AirQualityGermany/AirQuality-project-2018_2019-F.I.R-and-Geotab-GmbH/Pinouts and wiring overviews/WEMOS LOLIN32 V1.0.0 Wifi + Bluetooth Board Based ESP-32.JPG

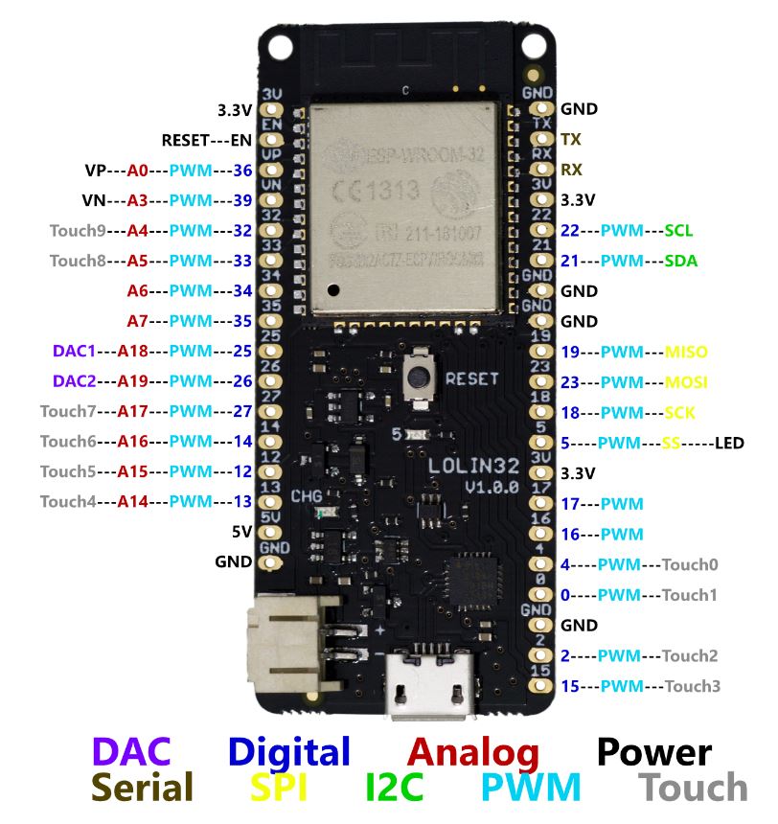
Pinouts and wiring overviews/WEMOS LOLIN32 V1.0.0 Wifi + Bluetooth Board Based ESP-32.JPG
