AirQualityGermany/AirQuality-project-2018_2019-F.I.R-and-Geotab-GmbH/Pinouts and wiring overviews/BME280-Wiring-Guide-Schematics-Guide-14core.jpg

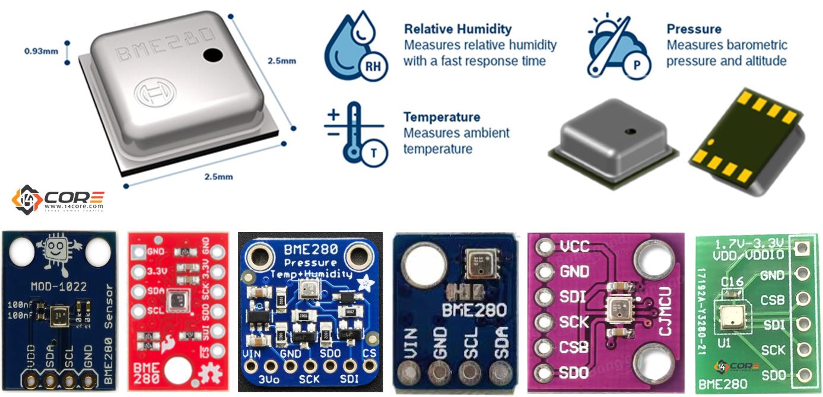
Pinouts and wiring overviews/BME280-Wiring-Guide-Schematics-Guide-14core.jpg
