AirQualityGermany/AirQuality-project-2018_2019-F.I.R-and-Geotab-GmbH/BluetoothBroadcasting/Broadcastdesign_v1_0.pdf

# Broadcast Design (v1.0)

Offset | 1 | 2 | 3 | 4 | 5 | 6 | 7 | 8 | 9 | 10 | 11 | 12 | 13 | 14 | 15 | 16 | 17 | 18 | 19 | 20 | 21 | 22 | 23 | 24 | 25 | 26
Value | 0x02 | 0x01 | 0x06 | 0x16 | 0xFF | 0x0275 | | 0x00 | 0xC6 | 0x64 | 0x07 | Data | Data | Data | 0x09 | Data | Data | Data | 0x0A | Data | Data | Data | 0XE6 | Data | 0xE7 | Data
Description | AD length (length = 2) | Flags | -LE Discov erable Moder – BR/DE R Not Suppor ted | AD length (length = 22) | Manuf acturer specifi c Data | Geotab‘s Company ID | | Adverti sing packet version numbe r | Tx Power Level (-58dBm ) | Batter y Power Level (100%) | Tempe rature | Temperature Data - Floating Point 24 Bit | | | Relativ e Humidi ty | Humidity Data - Floating Point 24 Bit | | | Barom etric Pressu re | Pressure Data - Floating Point 24 Bit | | | Generi c Byte 1 è PM2.5 | PM2.5 Data | Generi c Byte 2 è PM10 | PM 2.5 Data
1 | 2 | 1 | 2 | 3 | 4 | 5 | 6 | 7 | 8 | 9 | 10 | 11 | 12 | 13 | 14 | 15 | 16 | 17 | 18 | 19 | 20 | 21 | 22
standard | standard | Interesting data
Temperature | Relative Humidty | Barometric Pressure | PM 2.5 | PM 10
- Unit type: FP24
- 3 Byte
- Unit: °C | • Unit type: FP24 • 3 Byte • Unit: % | • Unit type: FP24 • 3 Byte • Unit: Pa | • Unit type: 1 Byte of data (0-255)
- 1 Byte
- Unit: -
| | | • Limit: 25 ug/m^3 | • Unit type: 1 Byte of data (0-255)
- 1 Byte
- Unit: -
| | | | • Limit: 50 ug/m^3
11 | 12 | 13 | 14
0x07 | 0x00 | 0x20 | 0x41
Identifier | Data
15 | 16 | 17 | 18
0x09 | 0x00 | 0xc8 | 0x42
Identifier | Data
19 | 20 | 21 | 22
0x09 | 0xcf | 0x6e | 0x49
Identifier | Data
23 | 24
0xE6 | 7
Identifier | Data
25 | 26
0xE7 | 8
Identifier | Data

Information must be conbverted to Floating Point 24 Bit (same as 32 bit, but 8 less significant bits dropped)

0x412000 (FP24) = 10 (dec)

Information is broadcasted as number between 0 and 255

0x42c800 (FP24) = 100 (dec) | 0x496ecf (FP24) = 978170 (dec) | 7=7 | 8=8
