AirQualityGermany/AirQuality-project-2018_2019-F.I.R-and-Geotab-GmbH/BluetoothBroadcasting/IMG_8301.jpg

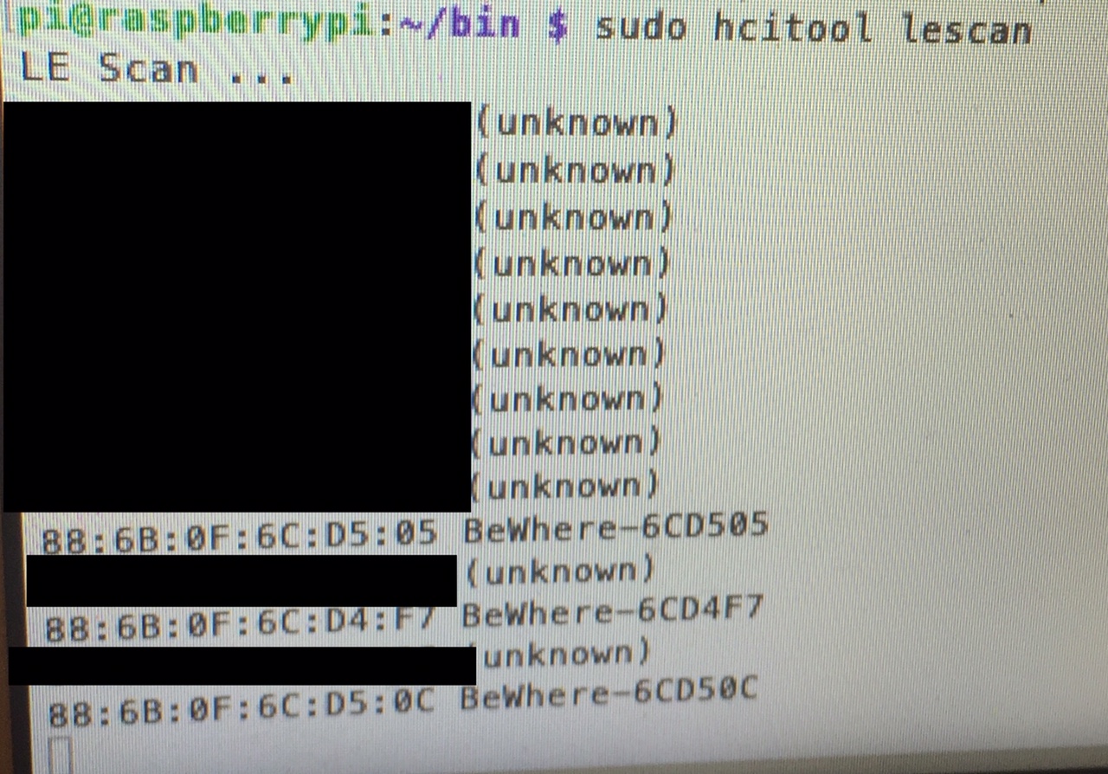
BluetoothBroadcasting/IMG_8301.jpg
