AirQualityGermany/AirQuality-project-2018_2019-F.I.R-and-Geotab-GmbH/Pinouts and wiring overviews/Cooking Hacks mics_2714_schematic.png

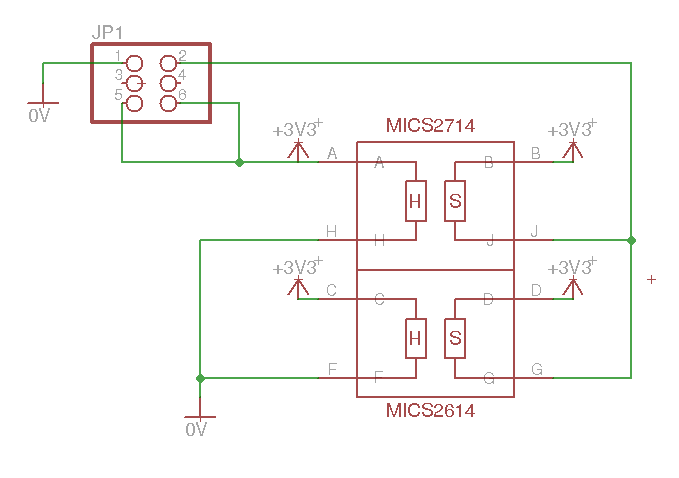
Pinouts and wiring overviews/Cooking Hacks mics_2714_schematic.png
