AirQualityGermany/AirQuality-project-2018_2019-F.I.R-and-Geotab-GmbH/Pinouts and wiring overviews/Schematic_ESP32-shield-bus-tethered_Sheet-1_20190210134041.pdf

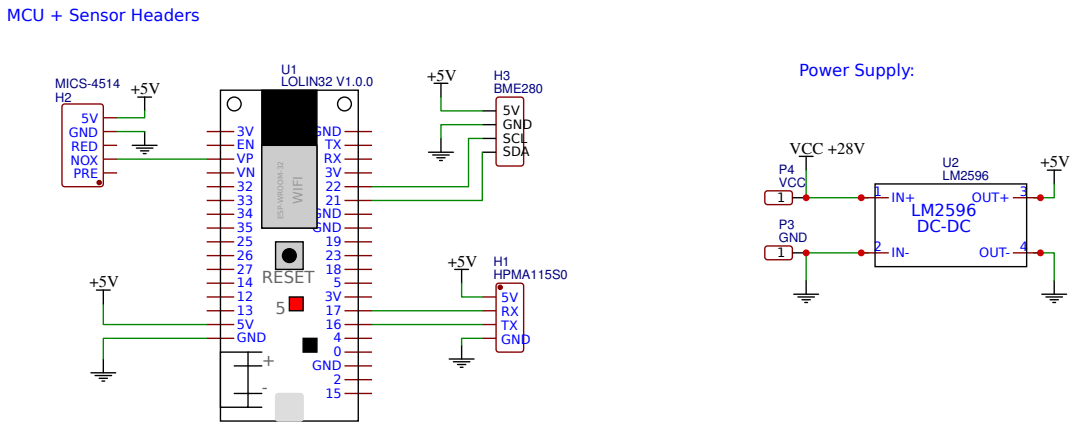
[picture p6: page 1]
TITLE:; Airquality Beacon ESP32 Tethered; REV: 1.0; Date:; Sheet: 1/1; Company: Geotab; LOLIN32 V1.0.0; 3V EN VP VN 32 33 34 35 25 26 27 14 12 13 5V GND; GND TX RX 3V 22 21 GND GND 19 23 18 5 3V 17 16 4 0 GND 2 15; RESET; 5ESP⁻WROOM⁻³²; WIFI; HPMA115S0; 5V RX TX GND; BME280; 5V GND SCL SDA; MICS-4514; PRE; NOX; RED; GND; VCC +28V; VCC; Power Supply:; OUT+ 3; OUT- 4

MCU + Sensor Headers

Drawn By: T. Halbrucker
