AirQualityGermany/AirQuality-project-2018_2019-F.I.R-and-Geotab-GmbH/Pinouts and wiring overviews/grafik.png

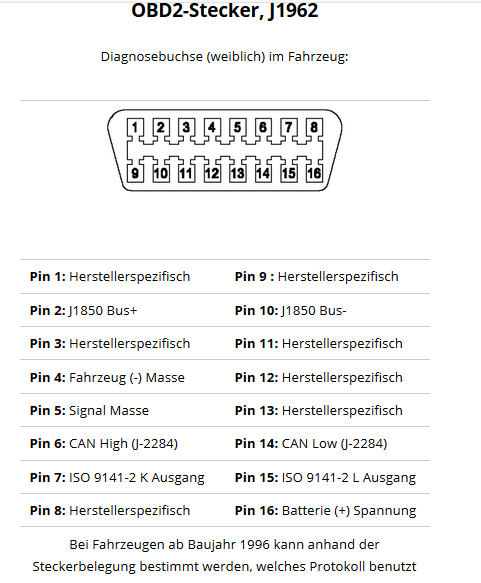
Pinouts and wiring overviews/grafik.png
