AirQualityGermany/AirQuality-project-2018_2019-F.I.R-and-Geotab-GmbH/(commit log)

2018-07-03 Initial commit
    sensortest.py
2018-07-26 Update README.md
    Sensor node build guide
2018-07-26 Update README.md
    DuPont jumper cable example
2018-08-28 Add files via upload
    Sensor 2 values (no Go7 connection yet) from Aug 28 2018
    Area Raeren/Belgium.
    Start time: 15:42
    End time: 23:16
    [logger_20180828_154227.csv]
2018-11-02 Add files via upload
    Using the bluetooth scan command on the raspberry, all three BeWhere Beacons where displayed.
2018-12-27 Create LOLIN32 V1.0.0 Wifi + Bluetooth Board Based ESP-32 4MB Flash
2018-12-27 Create Grove - Multichannel Gas Sensor from SEEED
2018-12-29 Arduino sketch for the ESP32 - initial upload
2019-01-12 Information added to replace RASPI with ESP32 board
2019-01-20 Update ESP32_BME280_HPM_Beacon_v1.1.ino
    NO2 sensor voltage measurement added
2019-03-07 Update ESP32_BME280_HPM_Beacon_v1.1.ino
    Bugfix in BLE Advertisement
